ngrabbs/antenna-pattern-rig/templates/antenna-lab/report.md

---
title: "Antenna characterization report"
subtitle: "Antenna ID: TBD | Report revision: TBD"
author: "Prepared by: TBD"
date: "Measurement date: TBD | Issue date: TBD"
lang: en-US
---

# Result

**Disposition:** DRAFT - replace after reviewing the completed worksheet.  
**Antenna / build revision / installed configuration:** TBD.  
**Purpose and claim evaluated:** TBD.

**Finding:** TBD - give the measured result, its conditions and a practical limit.

| Parameter | Result | Requirement / verdict |
| --- | --- | --- |
| Frequencies and measured cut | TBD | TBD |
| Input match / bandwidth | TBD | TBD |
| Peak direction / -3 dB beamwidth | TBD | TBD |
| Repeatability and uncertainty | TBD | TBD |
| Polarization / absolute gain, if established | TBD | TBD |

## Measurement configuration

**Source -> pad/filter -> source antenna -> range -> DUT -> receiver:** TBD.  
**Separation / antenna heights / surroundings:** TBD.  
**Source and received polarization component:** TBD.  
**Angle zero, sign convention and actual coverage:** TBD.  
**VNA reference plane / calibration check:** TBD.  
**Position reference / source-receiver settings / code revision:** TBD.

**Primary figure:** Add a relative PNG path using Markdown image syntax, with a
caption identifying frequency, cut, normalization, direction and run ID. TBD.

## Interpretation and limits

**Comparison to the original claim:** TBD.  
**Dominant uncertainties, background floor and unresolved effects:** TBD.  
**What these measurements do not establish:** TBD.

A normalized trace is relative level, not antenna gain in dBi. Do not present
simulation, encoder resolution or a controller tolerance as measured antenna
performance. Identify omitted polarization, efficiency or absolute-gain tests.

## Reproducibility and review

**Completed worksheet / raw-data archive / calibration and photo index:** TBD.  
**Run IDs / analysis commit / figure generation:** TBD.  
**Changes or excluded attempts:** TBD.  
**Operator / reviewer / review date:** TBD / TBD / TBD.  
**Next action:** TBD.
