ngrabbs/antenna-pattern-rig/templates/antenna-lab/style/lab-header.tex

% Readable single-column lab style, adapted from Nick's iPad/homework presets.
% Use basic TeX packages; no shared-volume paths or custom font install required.
\usepackage{xcolor}
\definecolor{LabBlue}{HTML}{173B58}
\definecolor{LabMuted}{HTML}{5A6873}
\usepackage{microtype}
\usepackage{setspace}
\setstretch{1.10}
\setlength{\parindent}{0pt}
\setlength{\parskip}{0.36em}
\setlength{\emergencystretch}{2em}
\usepackage{fancyhdr}
\pagestyle{fancy}
\fancyhf{}
\fancyhead[L]{\sffamily\small\color{LabBlue}ANTENNA LAB}
\fancyhead[R]{\sffamily\scriptsize\color{LabMuted}Worksheet / report}
\fancyfoot[L]{\sffamily\scriptsize\color{LabMuted}Record observations. Link evidence. Qualify claims.}
\fancyfoot[R]{\sffamily\small\thepage}
\renewcommand{\headrulewidth}{0.4pt}
\renewcommand{\footrulewidth}{0pt}
\fancypagestyle{plain}{\fancyhf{}\fancyfoot[L]{\sffamily\scriptsize\color{LabMuted}ANTENNA LAB}\fancyfoot[R]{\sffamily\small\thepage}\renewcommand{\headrulewidth}{0pt}}
\makeatletter
\renewcommand\section{\@startsection{section}{1}{0pt}{1.0em}{0.45em}{\Large\bfseries\sffamily\color{LabBlue}}}
\renewcommand\subsection{\@startsection{subsection}{2}{0pt}{0.7em}{0.3em}{\normalsize\bfseries\sffamily\color{LabBlue}}}
\makeatother
\setlength{\tabcolsep}{5pt}
\renewcommand{\arraystretch}{1.14}
\clubpenalty=10000
\widowpenalty=10000
\displaywidowpenalty=10000
