ngrabbs/antenna-pattern-rig/(commit log)

2026-10-21 Add rig documentation, encoder diagnostics, calibration plan and geometry tools
2026-10-21 Document verified original rotor flash readback and Docker tooling
2026-10-21 Record R250 driver settings and first live encoder test; add Docker build and capture
2026-10-21 Correct shield encoder takeoffs using continuity checks; record successful retest
2026-10-21 Add supervised Z-axis jog firmware, motion guards and persistent Docker serial control
2026-10-21 Add one-step observation diagnostic and document unresolved motor bring-up
2026-10-21 Record isolated full-step test with no encoder displacement
2026-10-21 Add bounded rubber-band transmission test and correct coupling assumptions
    [motion_logic.h, motion_session.py, motion_test.cpp, motor_jog.ino]
2026-10-21 Record repeated 20-step measurements and equal grooved pulleys
2026-10-21 Document three repeated motor increments and unacceptable encoder spread
2026-10-21 Add bounded 180-degree outward and return diagnostic with retained encoder zero
2026-10-21 Compare three encoder-referenced sweep cycles and add reproducible log summary
2026-10-21 Add bounded encoder-targeted 180-degree positioning and return test
2026-10-21 Record three successful encoder-targeted bench cycles and measured endpoint errors
2026-10-21 Record successful smoother 1/16-step mounted antenna sweep
2026-10-21 Capture first 2400 MHz moving antenna scan and add Docker RF tools
2026-10-22 Add guided antenna lab worksheet and Pandoc report workflow
